vmartpast/Proyecto_GUARD/hardware/fotos/interfaz_esp32.jpg

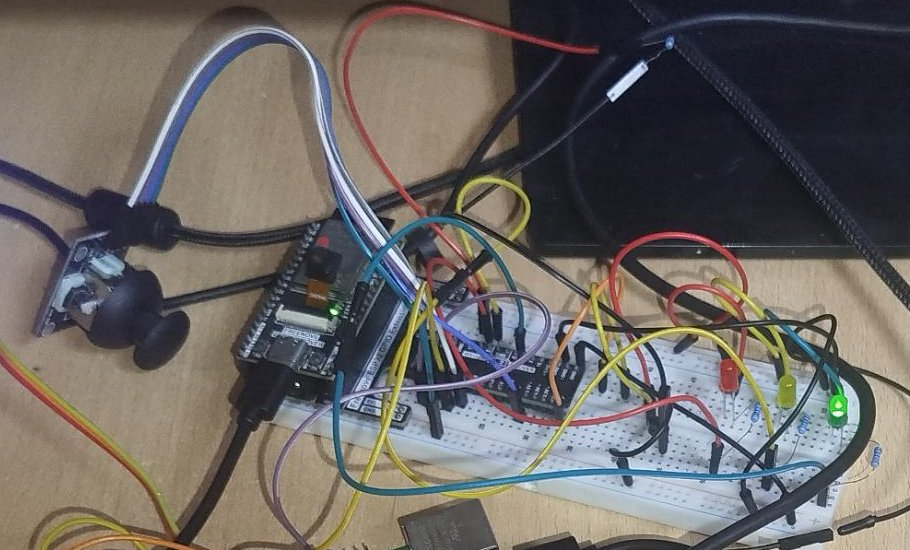
hardware/fotos/interfaz_esp32.jpg
