vmartpast/Proyecto_GUARD/hardware/fotos/panel_estado.jpg

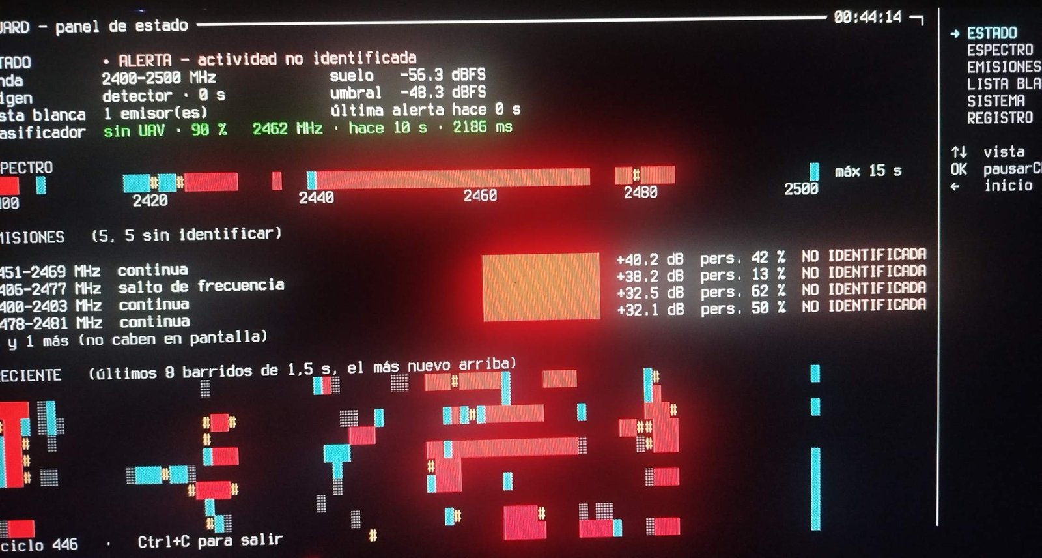
hardware/fotos/panel_estado.jpg
