vmartpast/Proyecto_GUARD/hardware/fotos/equipo_montado.jpg

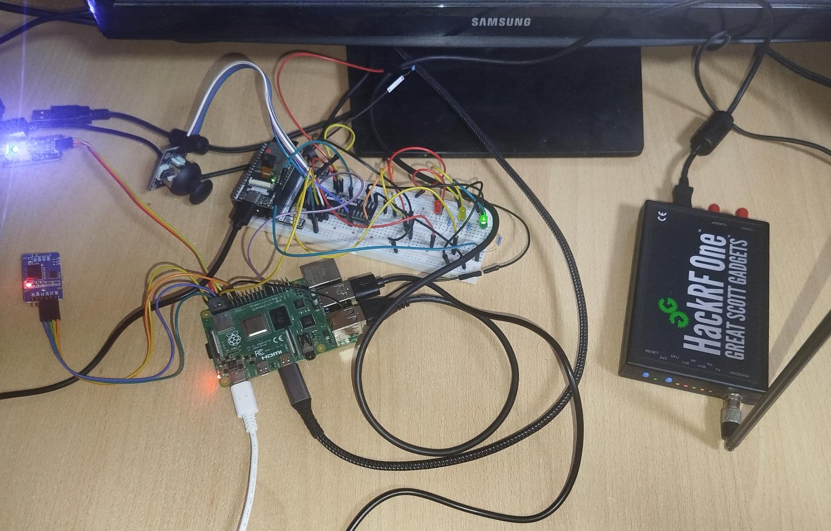
hardware/fotos/equipo_montado.jpg
