vmartpast/Proyecto_GUARD/hardware/fotos/panel_cascada.jpg

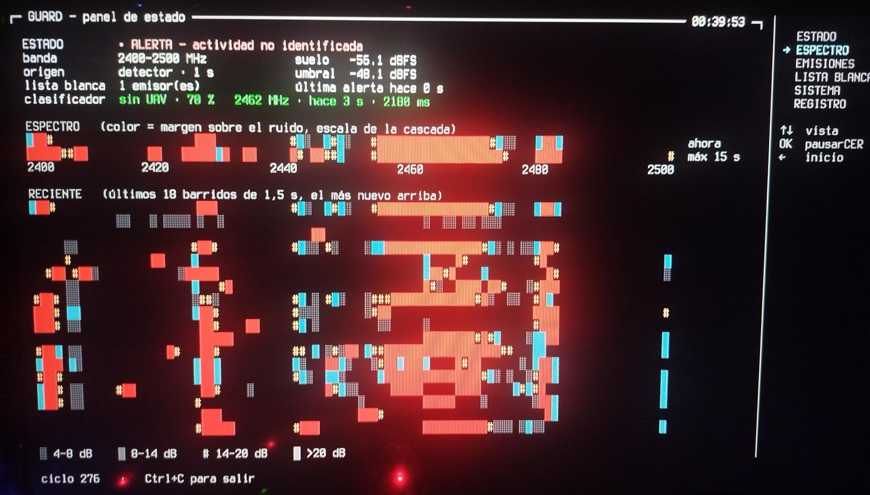
hardware/fotos/panel_cascada.jpg
