vmartpast/Proyecto_GUARD/resultados/reglas_alarma.md

Capturas de 0,5 s: externas 202, propias 134

| Regla | Sensibilidad UAV | FA externas (sin_uav) | FA propias | FA bluetooth_audio |
|---|---|---|---|---|
| R0 | 86.2 % | 14.3 % | 0.0 % (0/134) | 0.0 % |
| R1 | 74.4 % | 7.1 % | 0.0 % (0/134) | 0.0 % |
| R2 | 82.5 % | 11.9 % | 0.0 % (0/134) | 0.0 % |

Reparto de niveles por captura de 0,5 s:

| Conjunto | negativo | posible | fuerte |
|---|---|---|---|
| UAV externos | 13.8 % | 11.9 % | 74.4 % |
| sin_uav externos | 85.7 % | 7.1 % | 7.1 % |
| propios | 100.0 % | 0.0 % | 0.0 % |
