vmartpast/Proyecto_GUARD/resultados/reglas_alarma_s2s3.md

Capturas de 0,5 s: externas 202, propias 252

| Regla | Sensibilidad UAV | FA externas (sin_uav) | FA propias | FA bluetooth_audio |
|---|---|---|---|---|
| R0 | 85.0 % | 14.3 % | 0.4 % (1/252) | 0.7 % |
| R1 | 72.5 % | 7.1 % | 0.0 % (0/252) | 0.0 % |
| R2 | 80.6 % | 11.9 % | 0.0 % (0/252) | 0.0 % |

Reparto de niveles por captura de 0,5 s:

| Conjunto | negativo | posible | fuerte |
|---|---|---|---|
| UAV externos | 15.0 % | 12.5 % | 72.5 % |
| sin_uav externos | 85.7 % | 7.1 % | 7.1 % |
| propios | 99.6 % | 0.4 % | 0.0 % |
