vmartpast/Proyecto_GUARD/resultados/s3_modelo_actual.md

Modelo: pi_nuevo/modelo/modelo_guard.npz (2026-10-22T17:10:45.544590+00:00)

| Condicion | Ventanas | FA por ventana | Capturas 0,5 s | posible | fuerte | Alarma regla anterior | Alarma regla nueva | Confundido con |
|---|---|---|---|---|---|---|---|---|
| sesion 3, musica + youtube a la vez @ 2430 MHz | 300 | 2.7 % | 30 | 0 | 0 | 0.0 % | 0.0 % | uav_mavic_pro 6, uav_f450 2 |
| sesion 3, musica a 1 m @ 2423 MHz | 300 | 6.7 % | 30 | 0 | 0 | 0.0 % | 0.0 % | uav_mavic_pro 17, uav_f450 3 |
| sesion 3, musica a 1 m @ 2460 MHz | 300 | 17.0 % | 30 | 1 | 0 | 3.3 % | 0.0 % | uav_mavic_pro 51 |
| sesion 3, musica a 3 m @ 2441 MHz | 280 | 0.4 % | 28 | 0 | 0 | 0.0 % | 0.0 % | uav_mavic_pro 1 |
| **Total** | 1180 | 6.8 % | 118 | | | 0.8 % | 0.0 % | |
