vmartpast/Proyecto_GUARD/tests/resultados/pruebas_20261105_180552.txt

==============================================================================
  PRUEBAS GUARD   2026-11-05 18:04:58
  equipo guard-pi · Linux 6.18.39+rpt-rpi-v8 · Python 3.13.5 · commit 3227775
==============================================================================

Pruebas unitarias
------------------------------------------------------------------------------

Pruebas de integración
------------------------------------------------------------------------------
[FAIL  ] I1  ESP32: descarte de tramas corruptas  (5.5 s)
           válida: (sin respuesta); checksum incorrecto: <ERR|CS|*55; faltan campos: <ERR|FMT|*1A; demasiado larga: <ERR|FMT|*1A
[PASS  ] I2  Puente: estado del detector caído y recuperado  (0.3 s)
           unidad guard-detector-rf.service; paso a ERROR: 0.0 s; vuelta a OK tras arrancarlo: 0.0 s. Comprobar a la vista: LED ámbar durante la parada
[PASS  ] I3  Detector: lista blanca leída del fichero  (30.3 s)
           emisión 2400-2402 MHz declarada en el fichero; marcada como conocida tras reiniciar el detector (30 s). Lista blanca original restaurada
[FAIL  ] I4  Receptor: acceso exclusivo del detector  (0.1 s)
           hackrf_info con el detector activo: abrió el receptor; el detector real y el simulado se excluyen en systemd: sí

Pruebas de sistema
------------------------------------------------------------------------------
[PASS  ] S4  Receptor desconectado: estado sin datos  (18.1 s)
           estado sin_datos publicado 2 s después de la desconexión; se recuperó solo en 16 s al volver a conectarlo. Comprobar a la vista: panel en rojo

Resumen: 3 PASS · 2 FAIL · 0 SKIP · 0 MANUAL
